janghojong66/Surat-Indo-_Project/README.md

# Surat-Indo-_Project
탈선및장애물감지장치(Surat 인도향)
