janghojong66/Surat-Indo-_Project/LED_Output 정의_V1.0_250225.pptx

1. LED 출력 정보

SL-DEOD System

| POWER | HLT | | OBL | OBR | | OBL | OBR

| RUN | EB | | DEL | DER | | DEL | DER

번호 | 명칭 (LED 정보) | DEOD / MCD 운영 | 비고
1 | POWER | 전원 투입 시 On (Hardware Logic On/Off)
2 | RUN | MCU 동작 시 점멸 (500msec)
3 | HLT | 정상 동작 시 On / 이상 시 Off | MCD(Main Control Unit) : TCMS HLT 출력 동기화
4 | OBL, OBR, DEL, DER (Red) | 평상 시 Off / 해당 센서 이상 시 On
5 | EB | 평상 시 Off / 장애물 및 탈선 감지 시 On
6 | OBL, OBR, DEL, DER (Green) | 평상 시 Off / 해당 센서 동작(장애물 및 탈선) 시 On

## Slide 2

1. LED 출력 정보

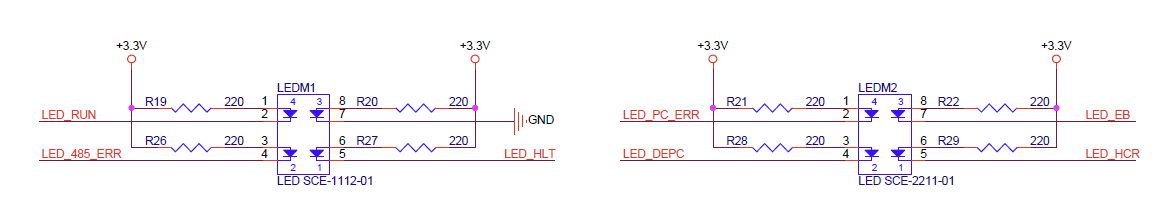
[picture p1: figure]

녹색, RUN

적색, POWER

적색, DEL

적색, OBL

녹색, EB

적색, HLT

적색, DER

적색, OBR

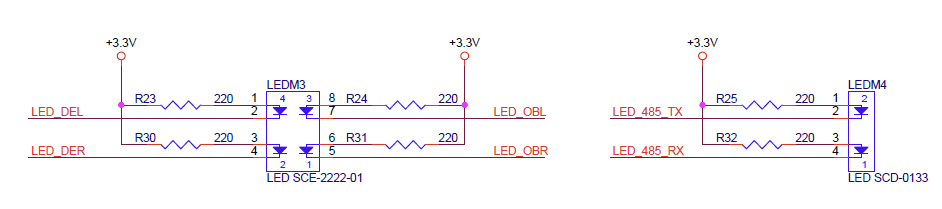
[picture p2: figure]

녹색, DEL

녹색, OBL

녹색, DER

녹색, OBR

사용안함, 제거
