janghojong66/Surat-Indo-_Project/Scheme/SL_DEOD_DEPC_CONTROL B_d.pdf

V1.0 | 2024년 10월 23일 | Initial Release for Rev 1.0

# SIL2 SL-DEOD (Shalom-DE-railment and Obstacle Detector) Control Unit Board

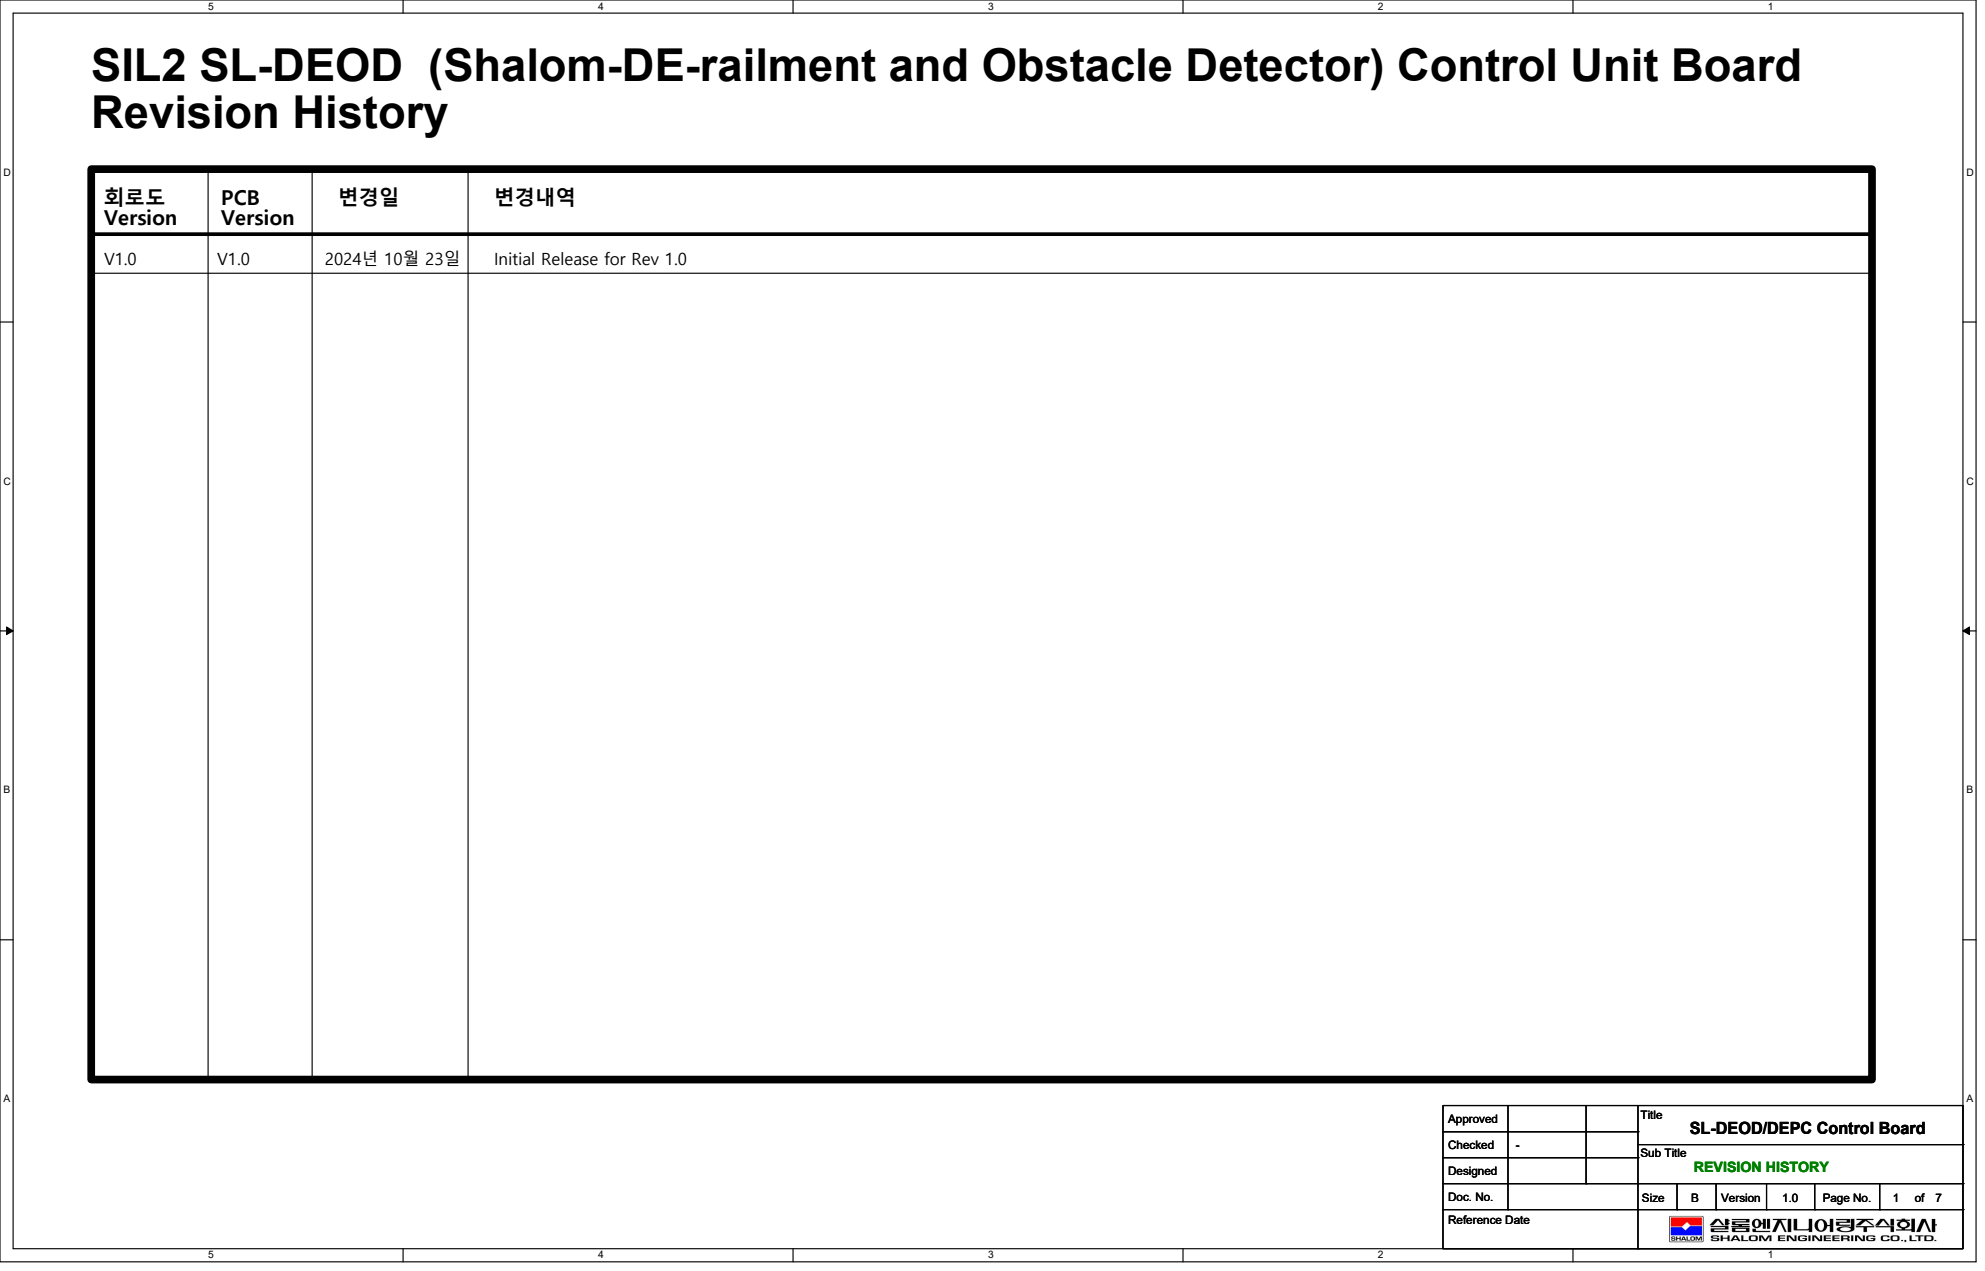
[picture p3: page 1]
Revision History; 회로도 Version; PCB; 변경일; Version; 변경내역; Sub Title Doc. No.; Size; Approved; Title Checked Designed; - REVISION HISTORY

SL-DEOD/DEPC Control Board

Page No. Reference Date

# STM32F407VGT6 ARM M4 MCU

MCU RESET SWITCH | JTAG CONNECTOR

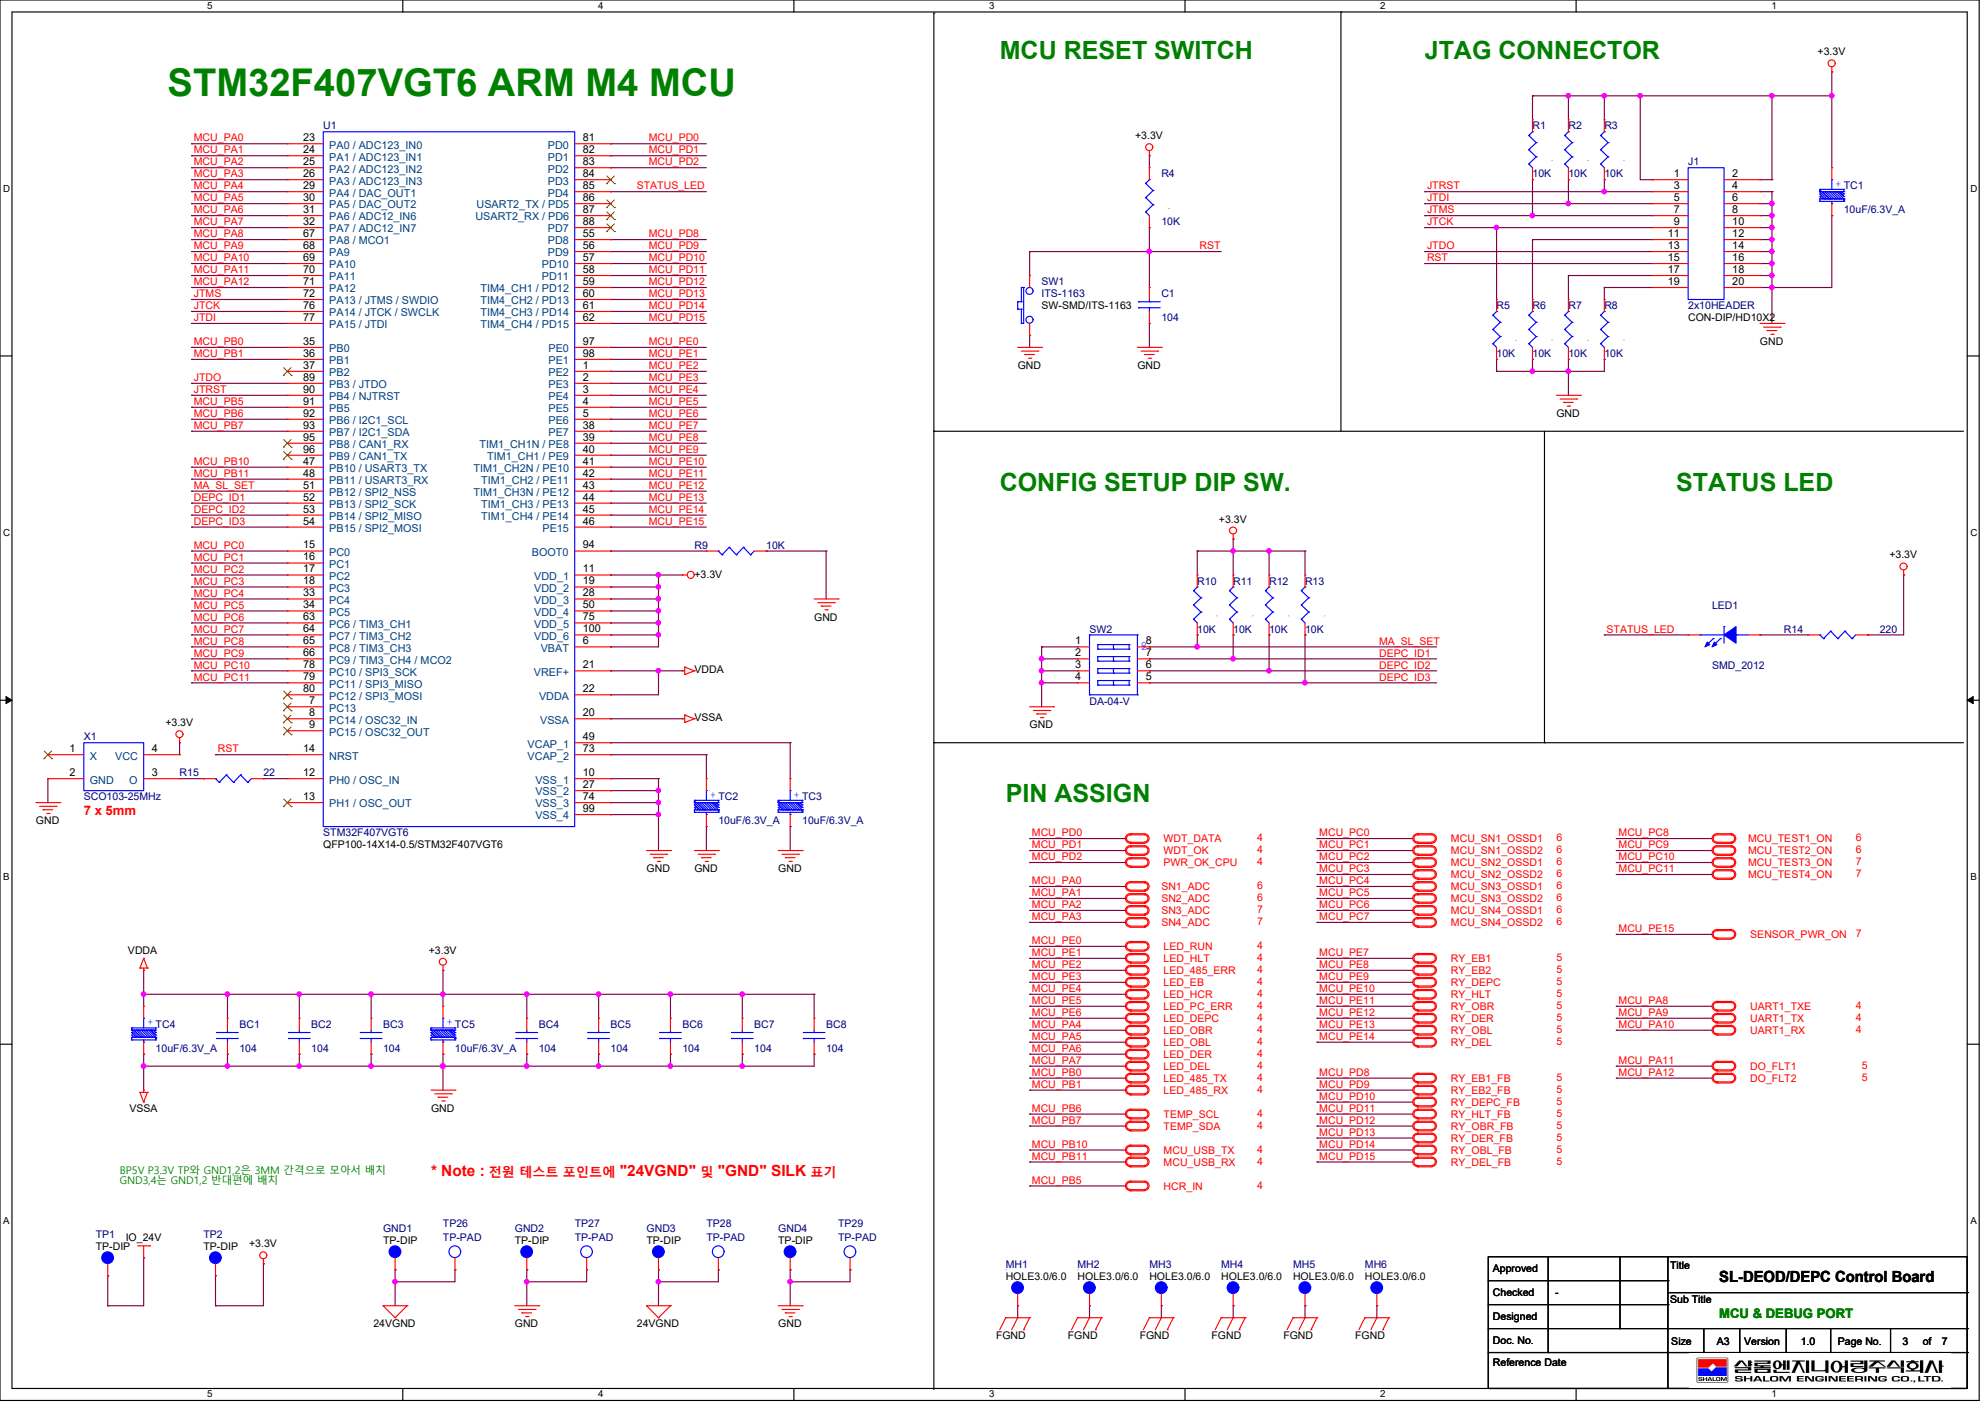
[picture p4: page 2]

ITS-1163 SW-SMD/ITS-1163

BP5V P3.3V TP와 GND1,2은 3MM 간격으로 모아서 배치
GND3,4는 GND1,2 반대편에 배치

* Note : 전원 테스트 포인트에 "24VGND" 및 "GND" SILK 표기

SL-DEOD/DEPC Control Board

# ISOLATED RS-485 INTERFACE (19200bps) ISOLATED USB-UART INTERFACE (115200bps)

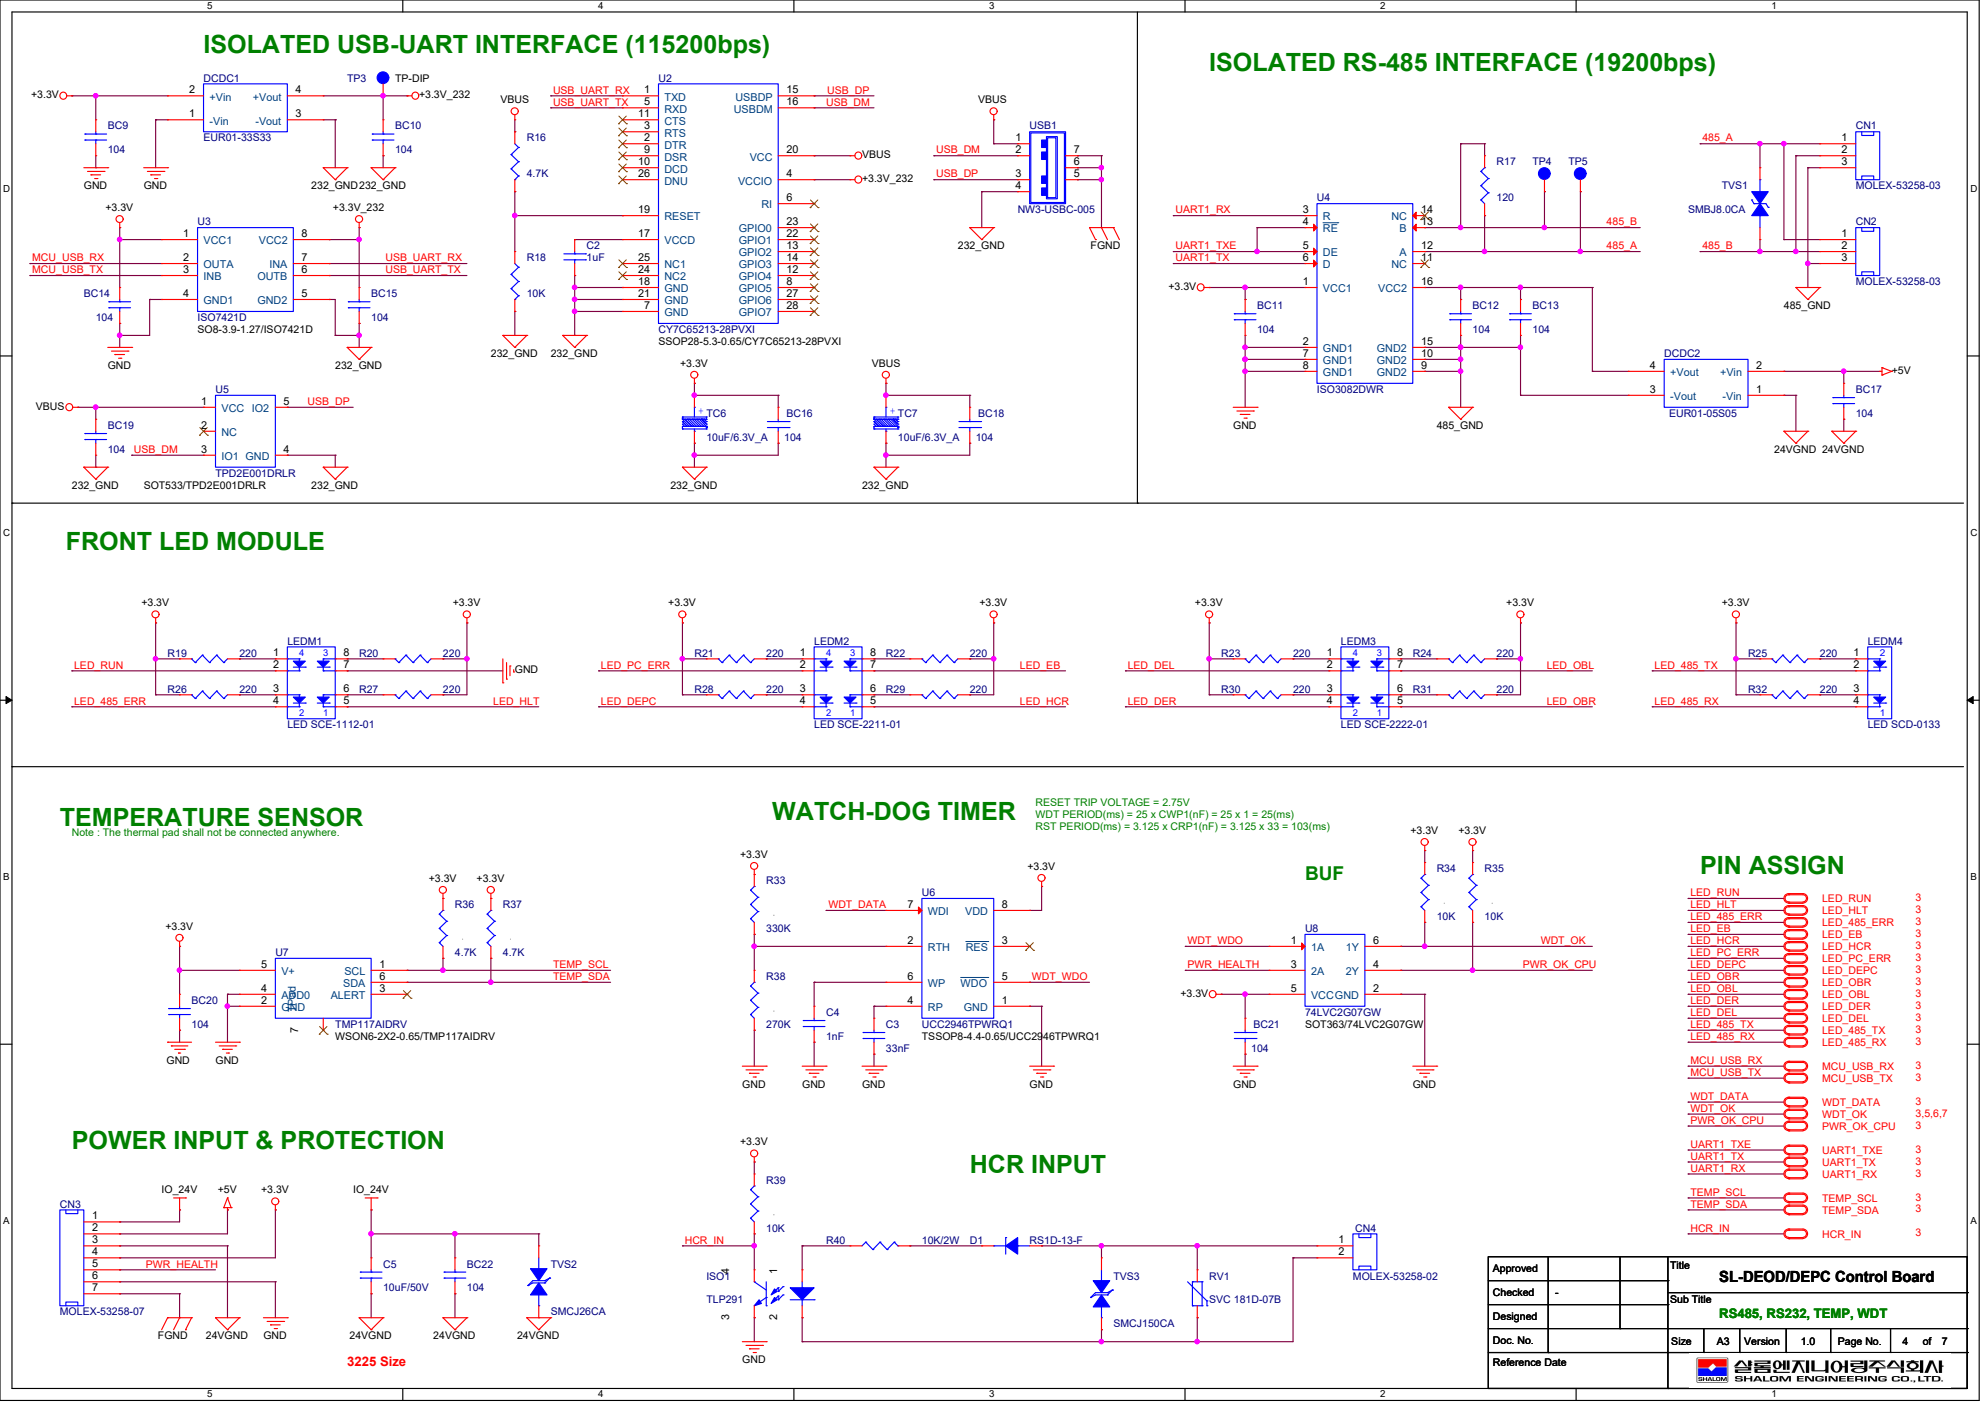
[picture p5: page 3]

Note : The thermal pad shall not be connected anywhere.

SL-DEOD/DEPC Control Board

# DIGITAL OUTPUT ISOLATOR

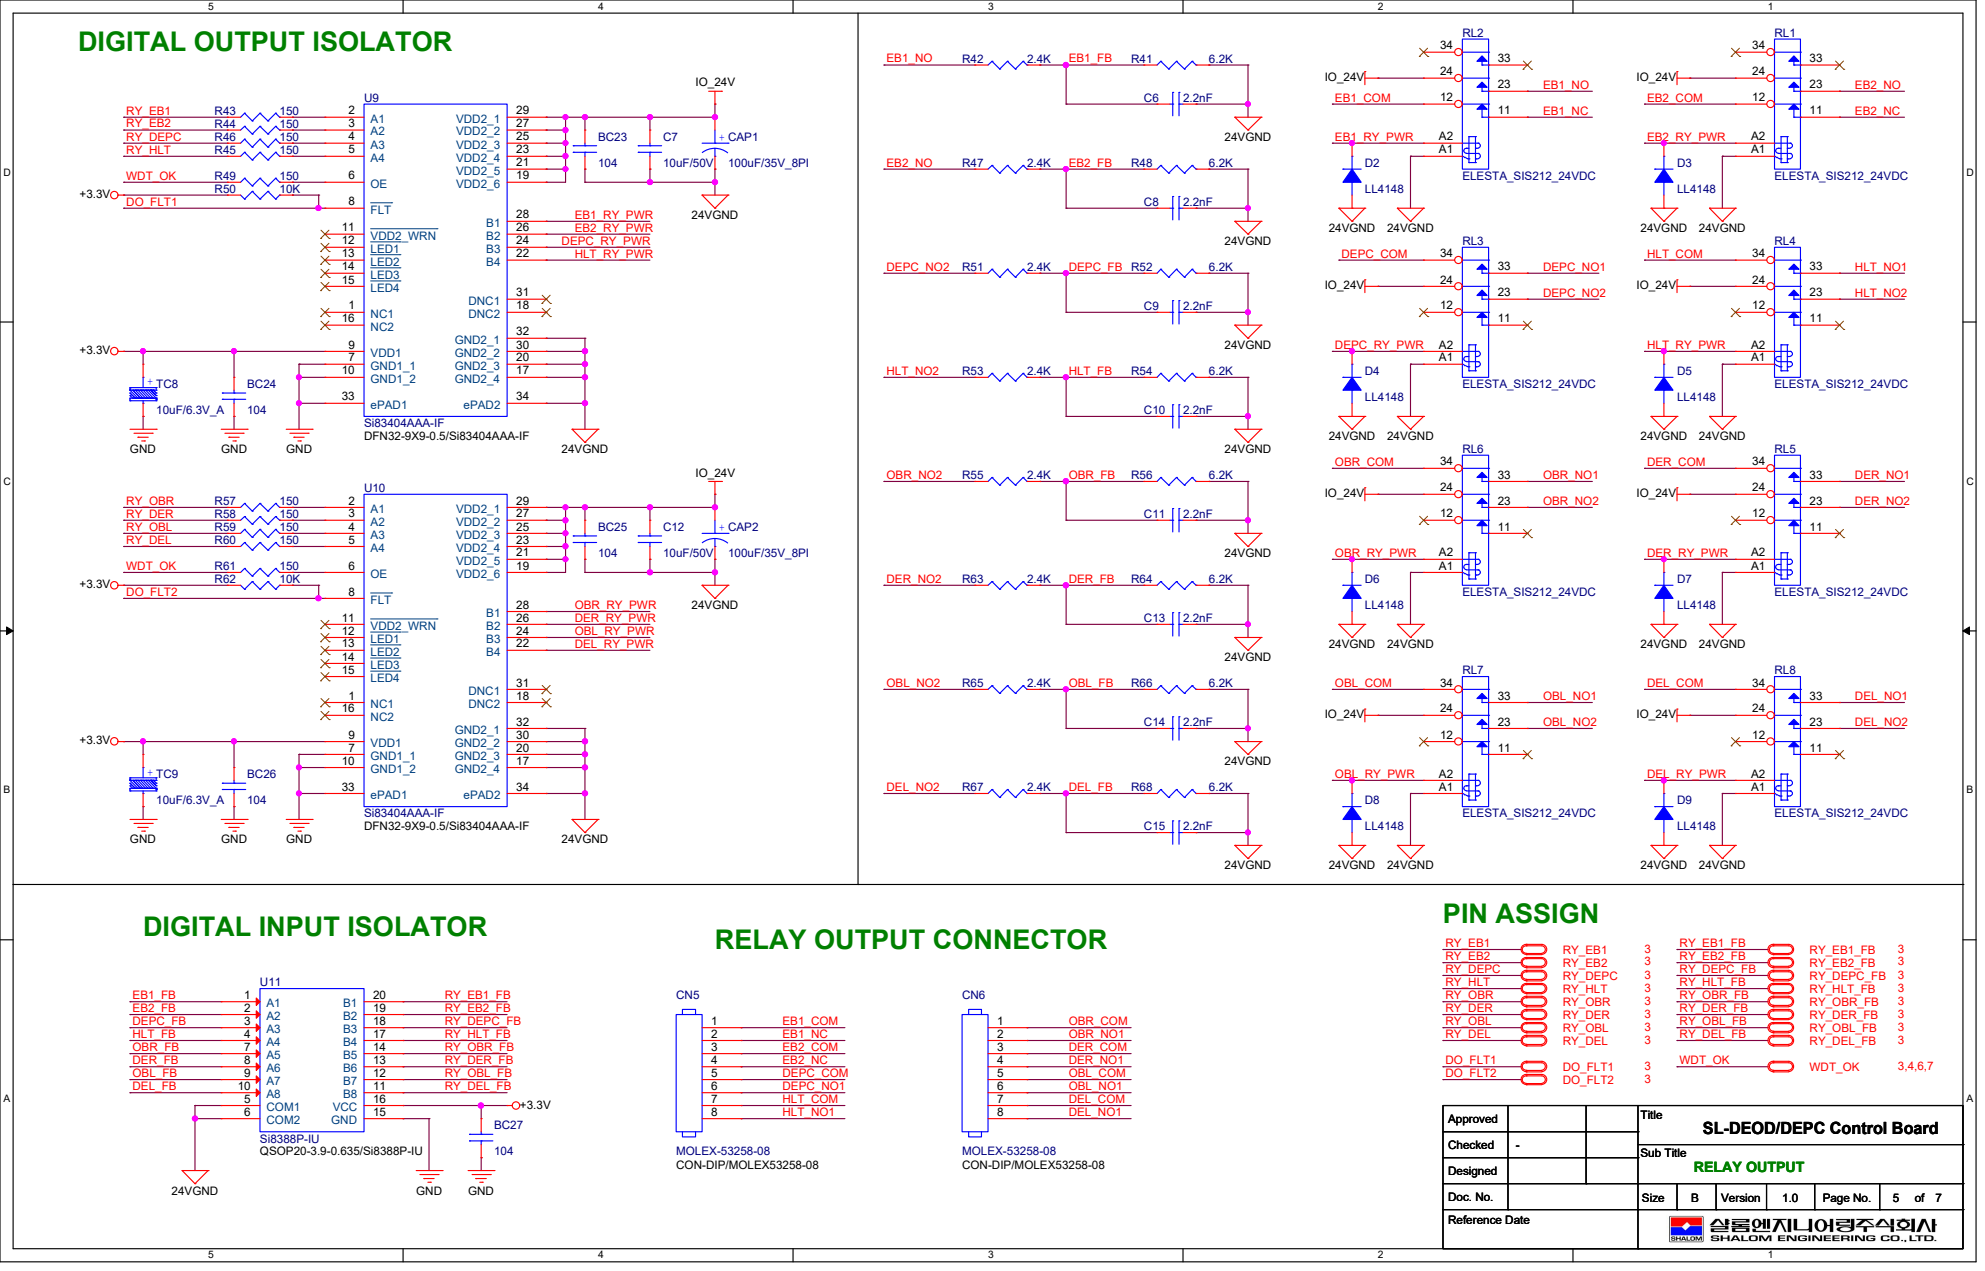
[picture p6: page 4]

B | 24VGND R66 6.2K | B

SL-DEOD/DEPC Control Board

Page No. Reference Date

# SAFETY SENSOR INPUT #1 (OSSD)

SAFETY SENSOR INPUT #2 (OSSD) | TEST LOGIC [SENSOR #1/#2]

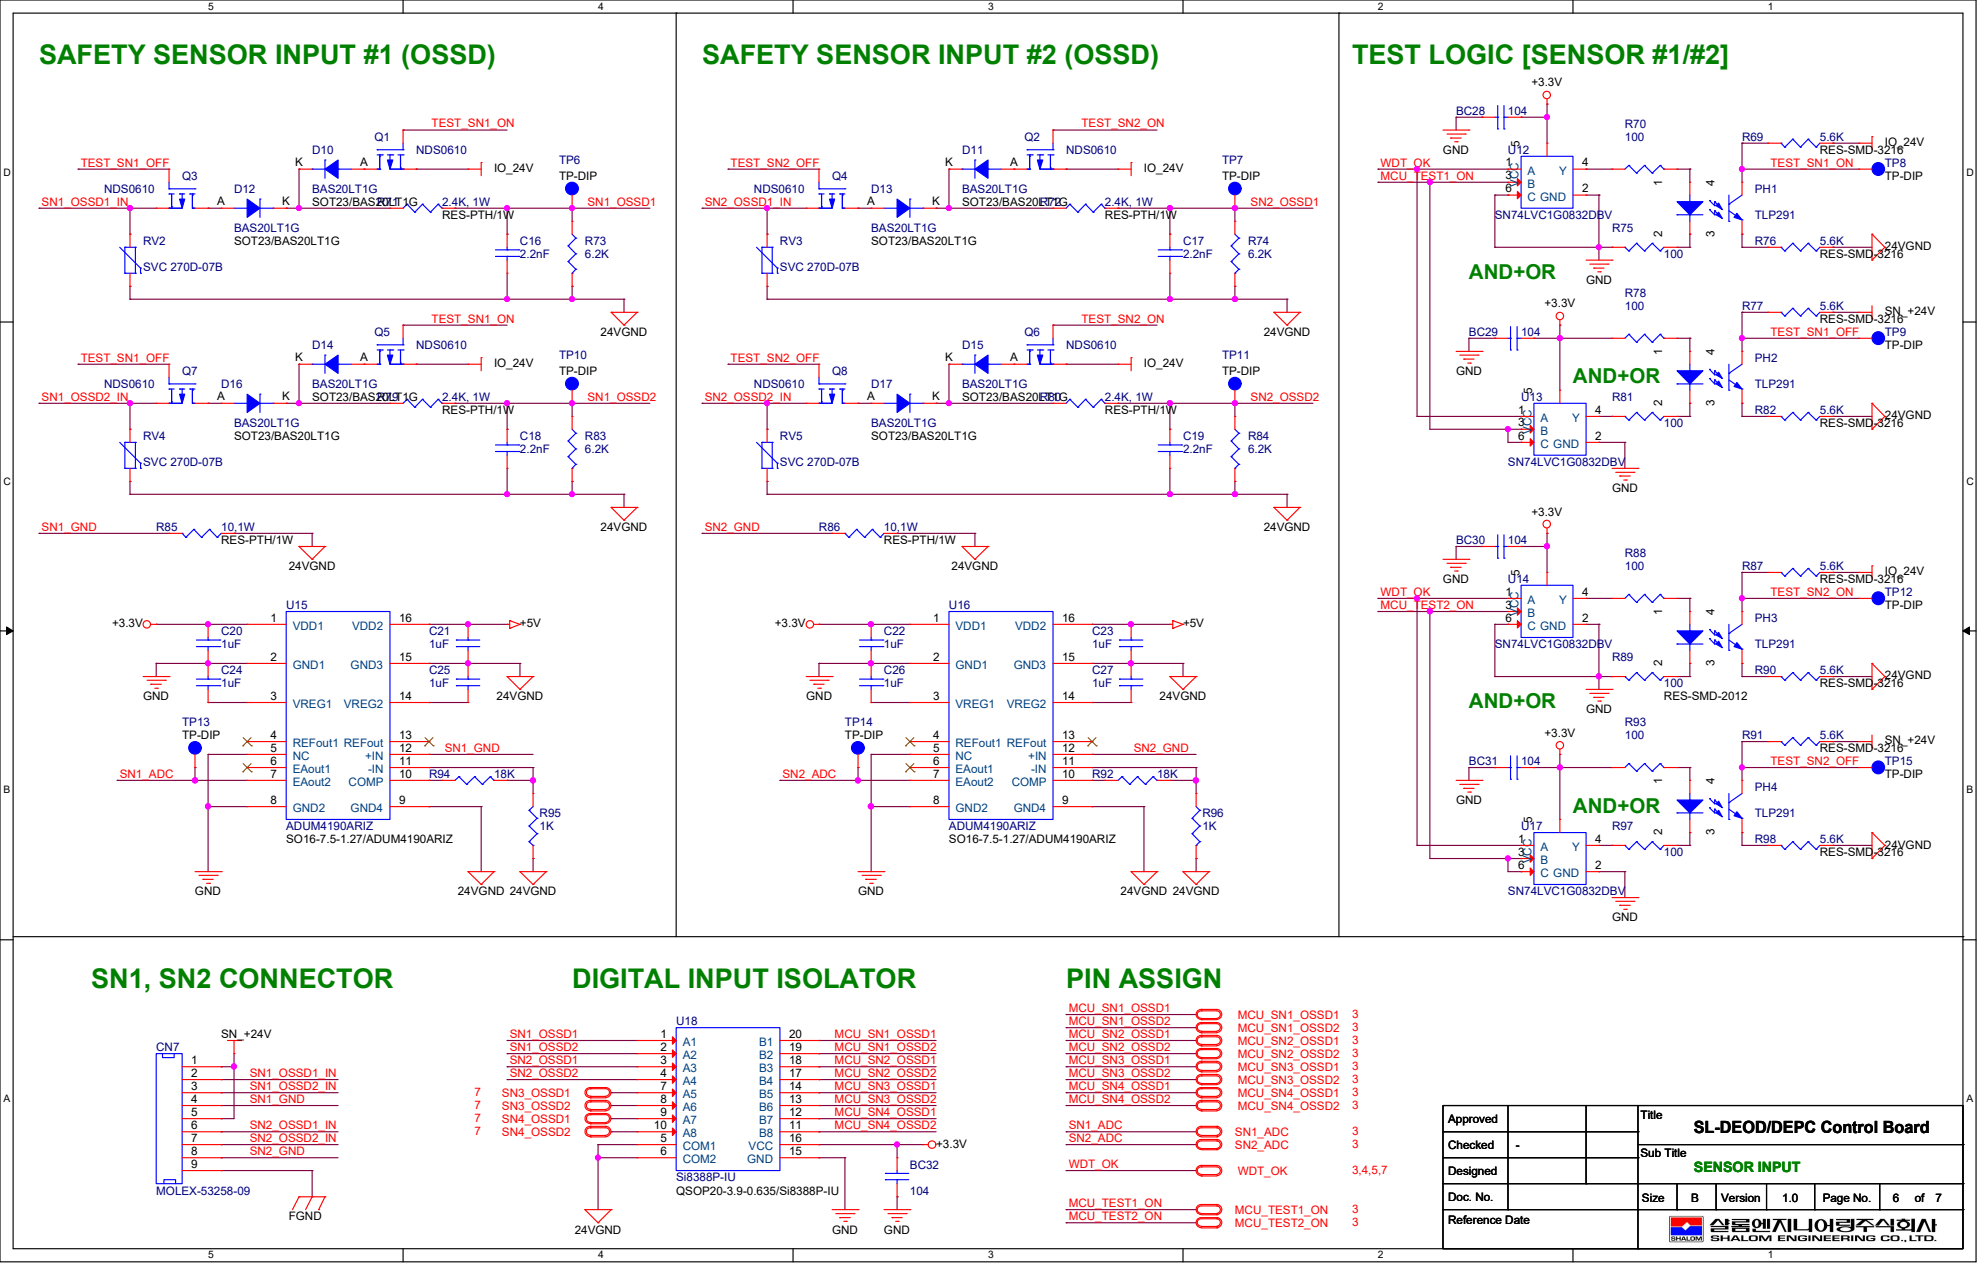
[picture p7: page 5]

SL-DEOD/DEPC Control Board

Page No. Reference Date

# SAFETY SENSOR INPUT #3 (OSSD)

SAFETY SENSOR INPUT #4 (OSSD) | TEST LOGIC [SENSOR #3/#4]

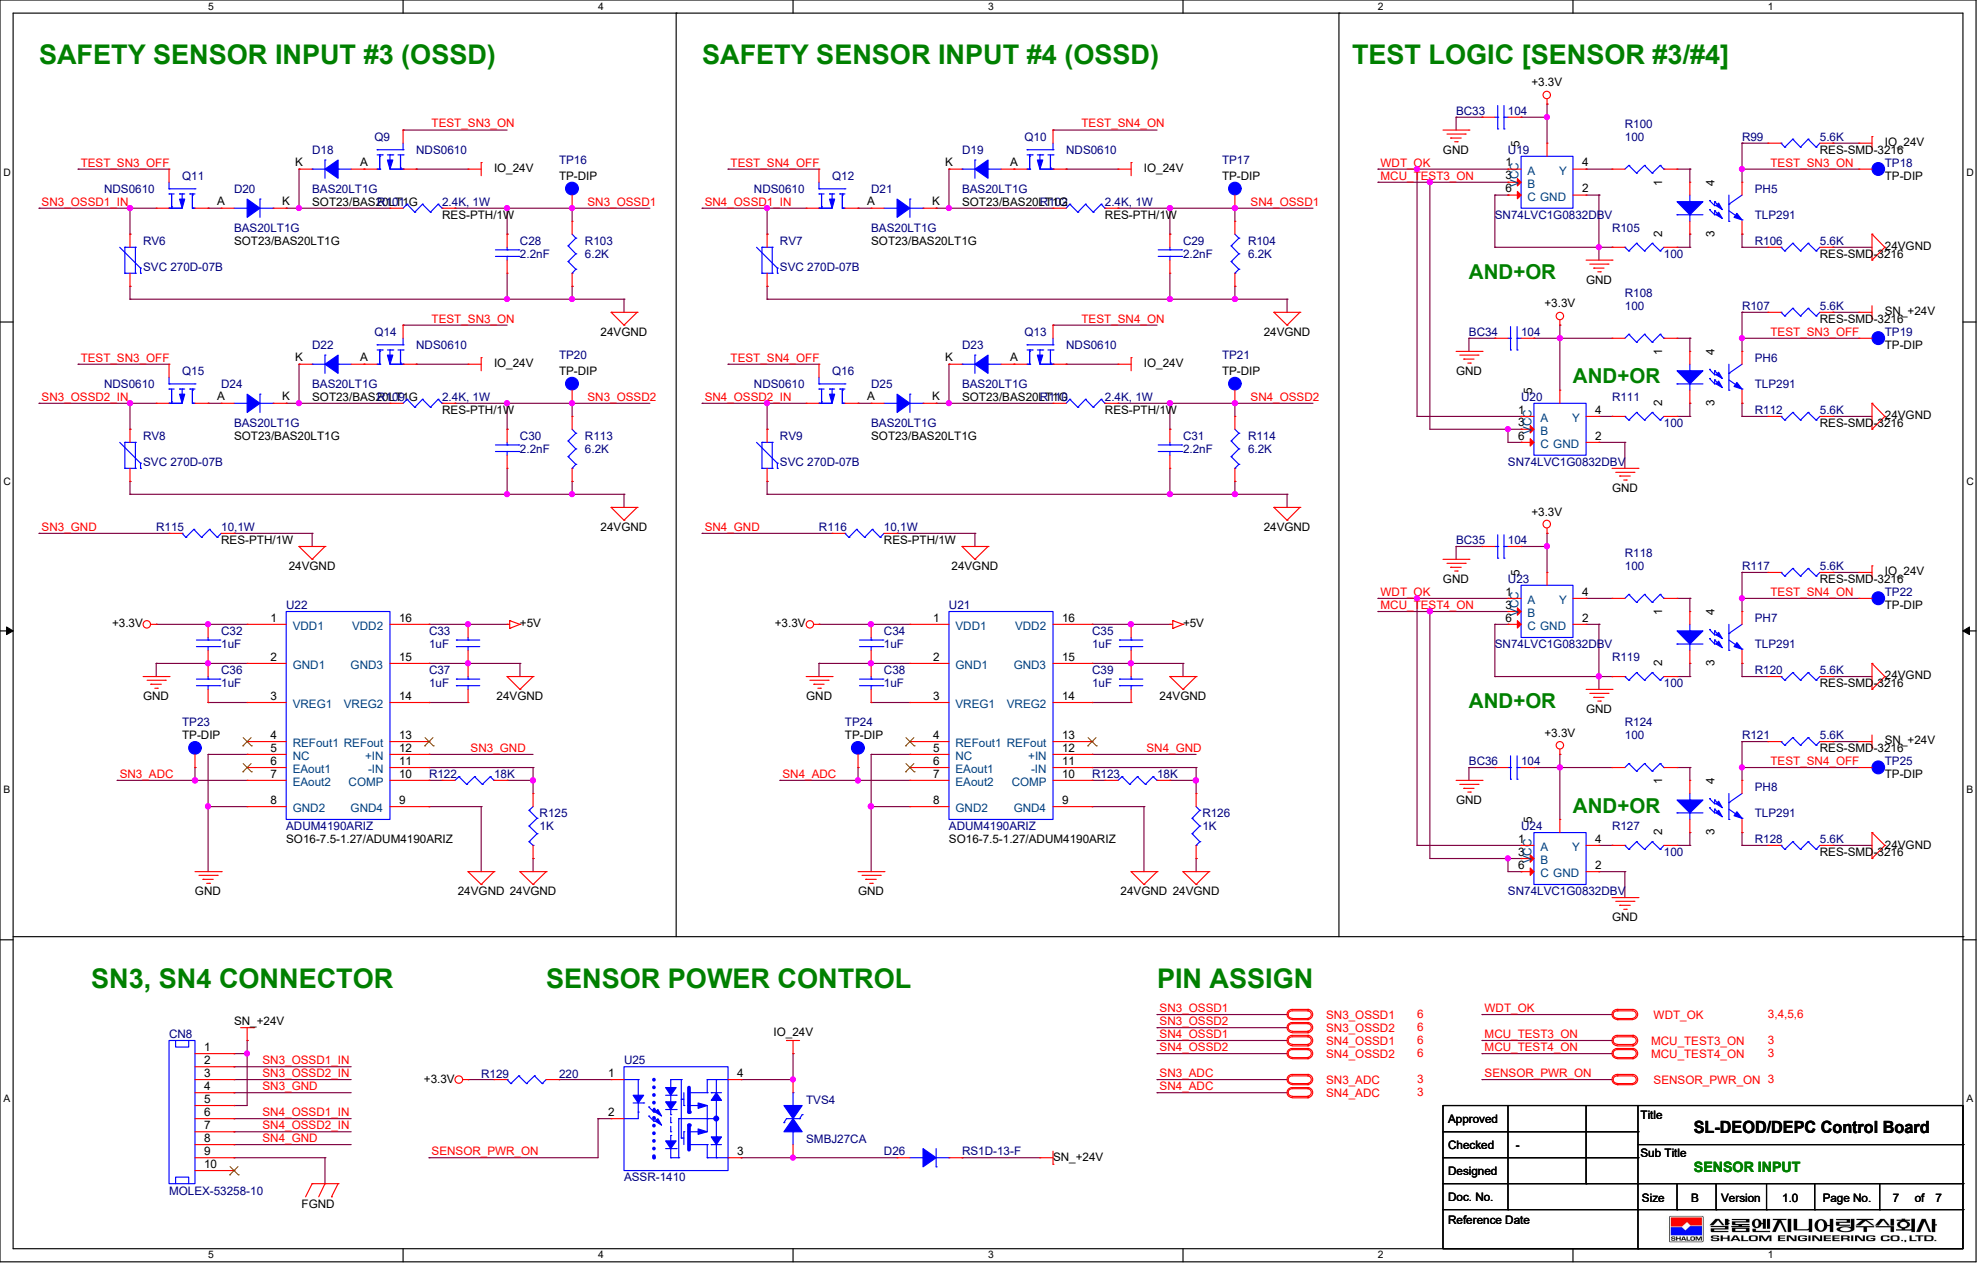
[picture p8: page 6]

SL-DEOD/DEPC Control Board

Page No. Reference Date
