janghojong66/Surat-Indo-_Project/Scheme/SL_DEOD_DEPC_POWER B_d.pdf

# SIL2 SL-DEOD (Shalom-DE-railment and Obstacle Detector) Power Unit Board Revision History

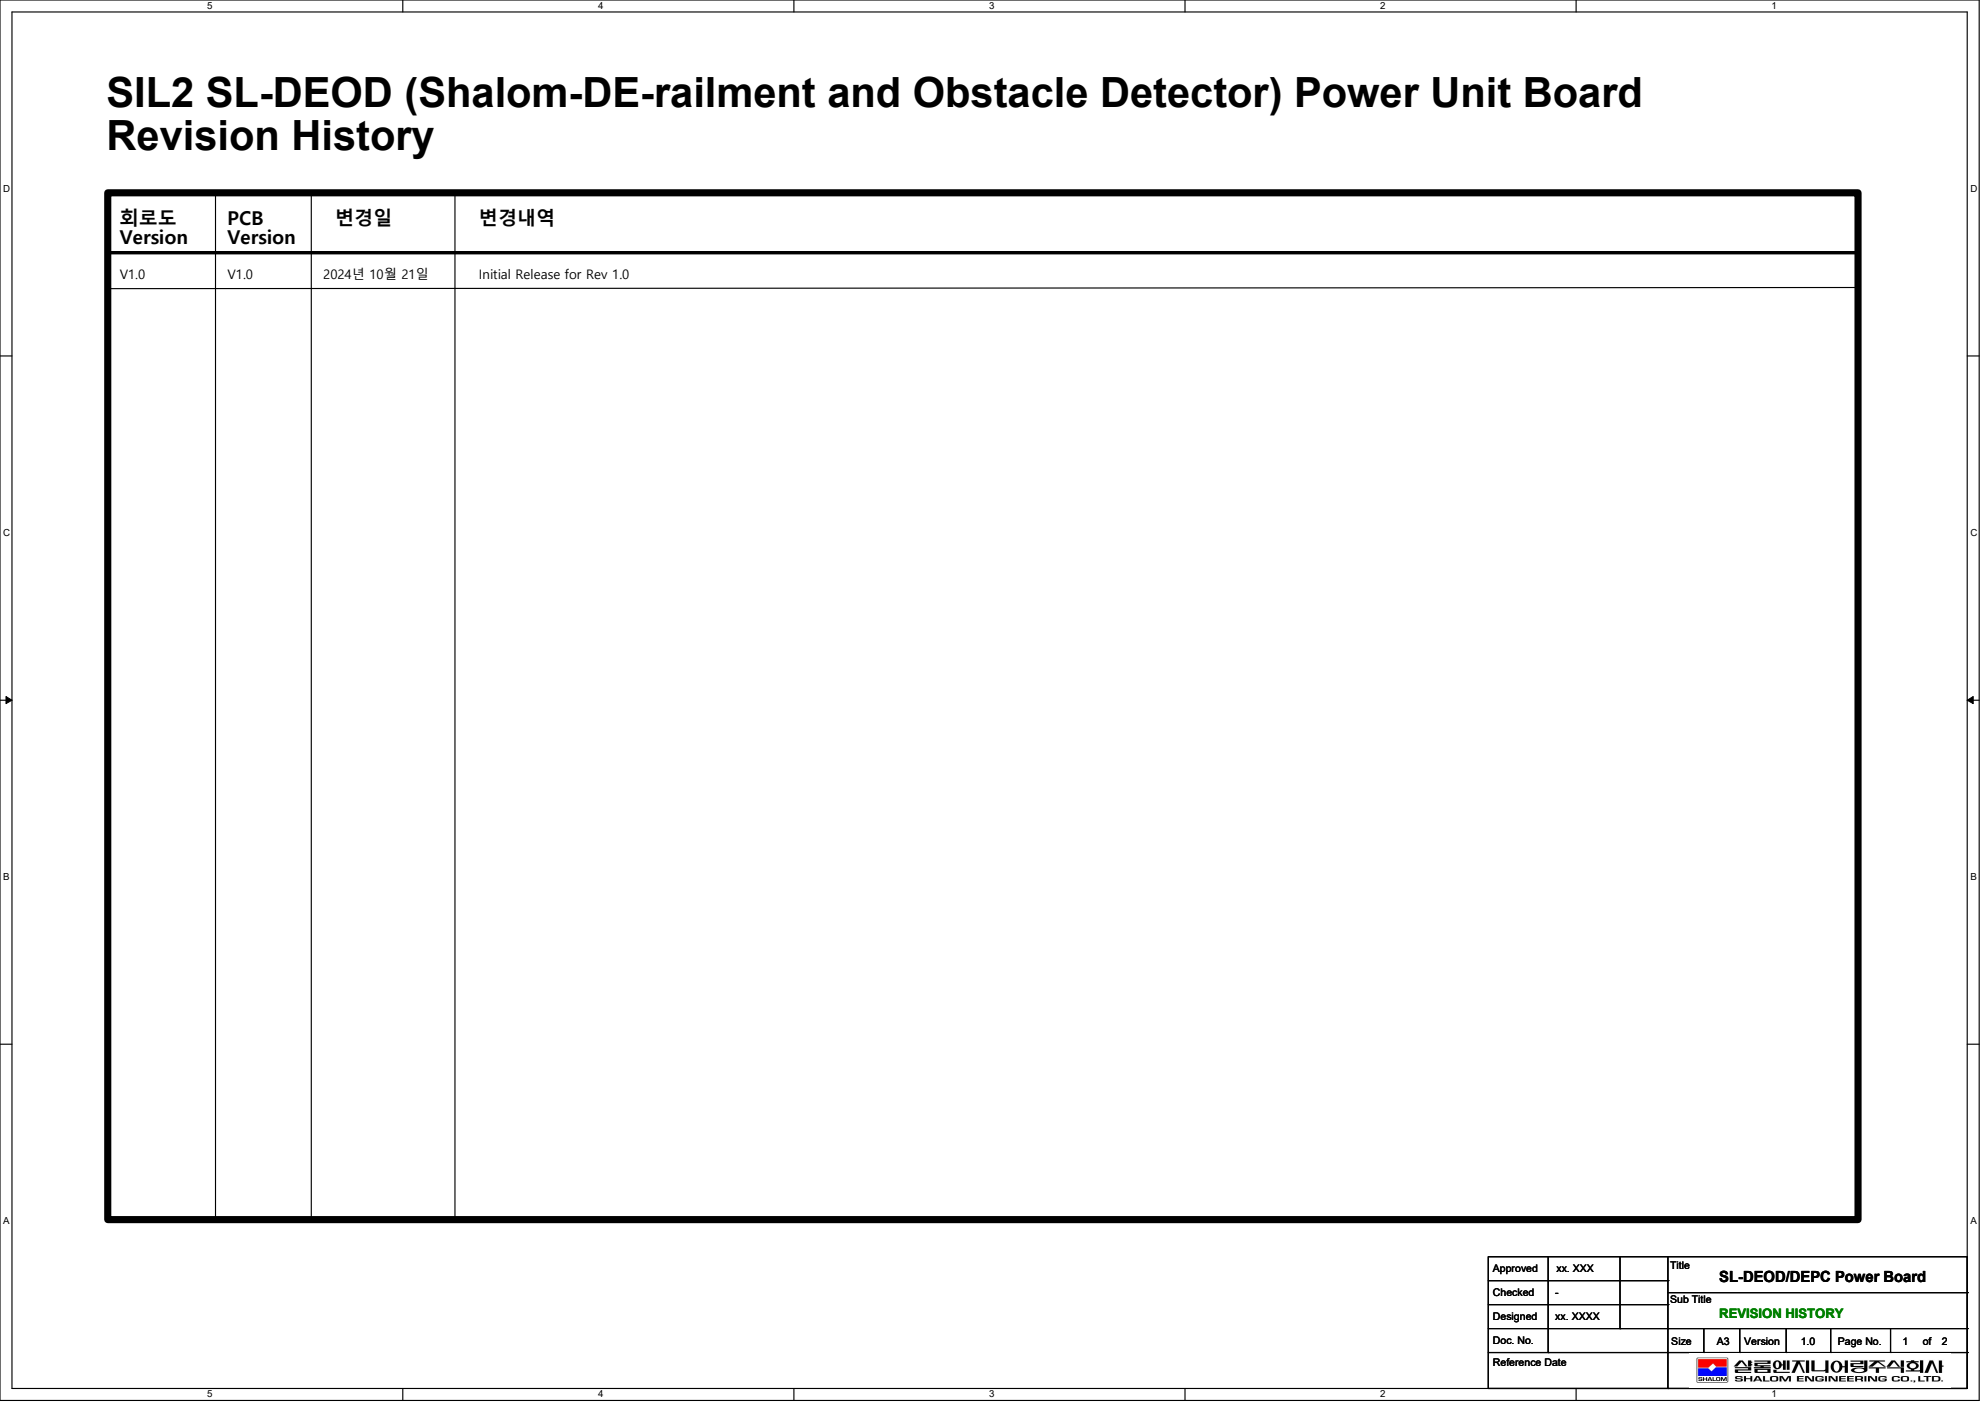
[picture p9: page 1]
Initial Release for Rev 1.0; PCB; 변경일; 변경내역; Version; 회로도 Version; Sub Title Doc. No.; Size; Title Approved Checked Designed; Page No. Reference Date; xx. XXXX; xx. XXX; - REVISION HISTORY

SL-DEOD/DEPC Power Board

### 5mm Pitch 13PI / Dip

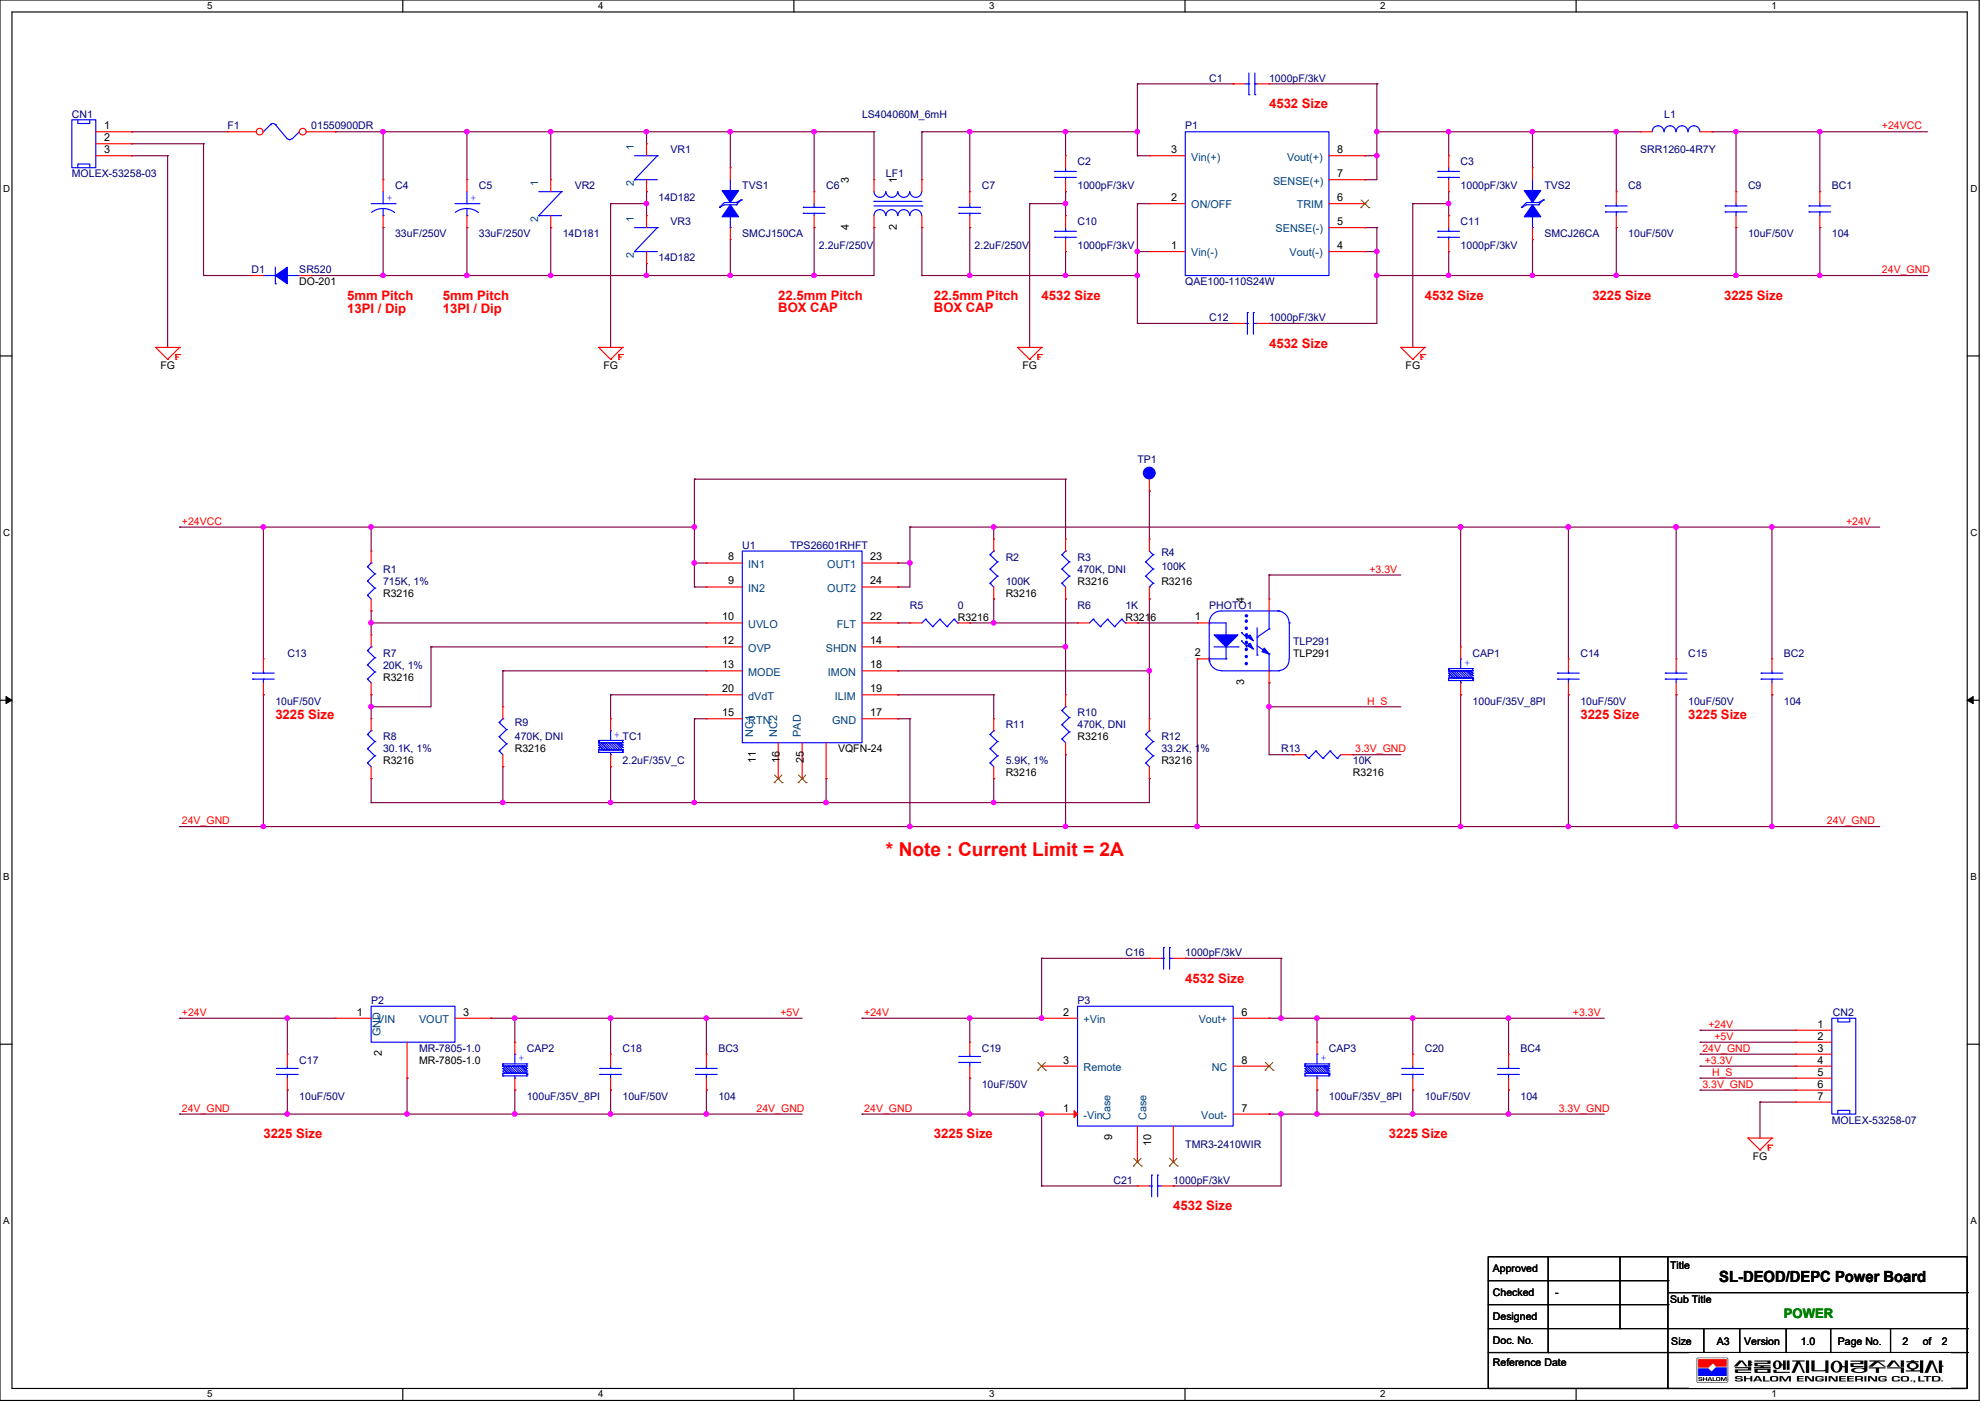
[picture p10: page 2]

SL-DEOD/DEPC Power Board
